sparkfun/Spectacle_Director_Board/Firmware/test.txt

SPEC
128
1
B
N
n
1.0
1.0
1.0
n
1.1
1.0
1.1
n
1.2
1.0
1.2
n
1.3
1.0
1.3
n
1.4
1.0
1.4
n
1.5
1.0
1.5
n
1.6
1.3
1.6
n
1.7
1.3
1.7
N
n
1.0
2.500
1.0
1.0
4.0
4.750
n
1.1
2.500
1.1
1.0
4.0
4.750
n
1.2
2.500
1.2
1.0
4.0
4.750
n
1.3
2.500
1.3
1.0
4.0
4.750
n
1.4
2.500
1.4
1.0
4.0
4.750
n
1.8
2.500
1.0
1.0
4.0
4.750
V
8
5
2000
Y
X
