sparkfun/Spectacle_Director_Board/(threads)

Thread 4 (2017-08-08):

No delay and no waiting loop needed after Wire.requestFrom().

Koepel, 2017-08-08:
In the file "spectacle_comms.ino" the Wire.requestFrom() is used five times. The code is not correct for all five.

The Wire.requestFrom() reads data and waits until the I2C transaction has finished. After that the received data is in a buffer in the Wire library. The Wire.read() retrieves data from that buffer and Wire.available() tells how many bytes are in that buffer.

There is nothing to wait for. The while-loops after the Wire.requestFrom() can be removed.

The isRead() function reads a byte when something is Wire.available(). That Wire.read() not needed. The next I2C transaction will start with a cleared buffer. The delay(5) after the Wire.requestFrom() is not needed for the check, but other code might depend on that delay by now.
