sparkfun/Spectacle_Director_Board/Hardware/Spectacle_Director_Board.brd

## EAGLE design Hardware/Spectacle_Director_Board.brd (2017-02-08)

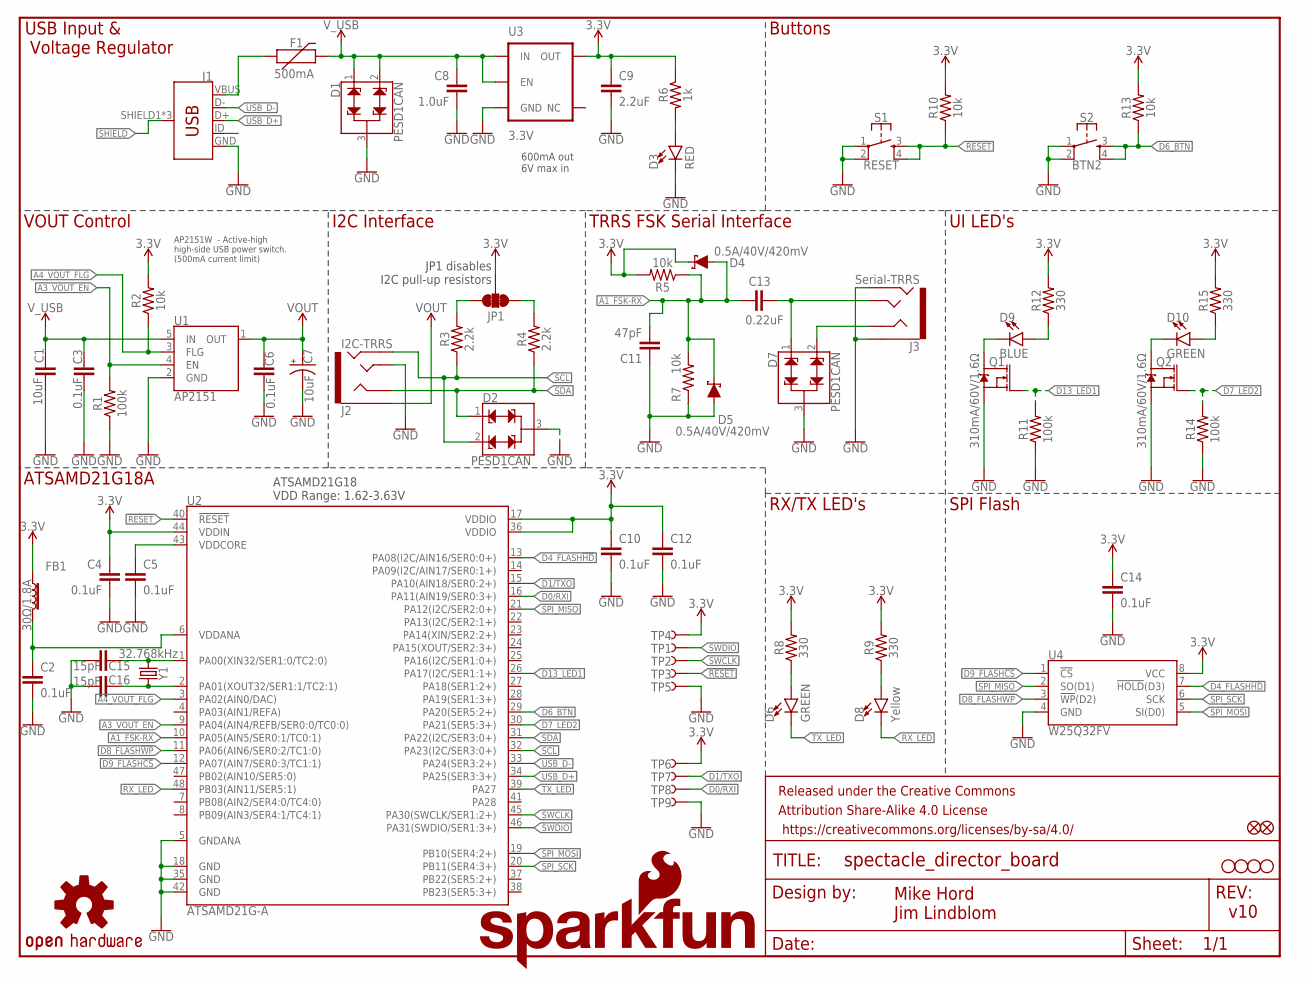
[picture p1: schematic Spectacle_Director_Board.sch]

Parts:
C1: 10uF; 0805
C2, C3, C4, C5, C6, C10, C12, C14: 0.1uF; 0603
C7: 10uF; EIA3216
C8: 1.0uF; 0805
C9: 2.2uF; 0603
C11: 47pF; 0603
C13: 0.22uF; 0603
C15, C16: 15pF; 0603
D1, D2, D7: PESD1CAN; SOT23-3
D3: RED; LED-0603
D4, D5: 0.5A/40V/420mV; SOD-323
D6, D10: GREEN; LED-0603
D8: Yellow; LED-0603
D9: BLUE; LED-0603
F1: 500mA; PTC-1206
FB1: 30Ω/1.8A; 0603
FD1, FD2: FIDUCIALUFIDUCIAL; FIDUCIAL-MICRO
FRAME1: FRAME-LETTER; CREATIVE_COMMONS
H1, H2, H3, H4: STAND-OFF
J1: USB_MICRO-B_FEMALE-SMT; USB-B-MICRO-SMD
J2: I2C-TRRS; AUDIO_JACK_3.5MM_TRRS_SMD_RA
J3: Serial-TRRS; AUDIO_JACK_3.5MM_TRRS_SMD_RA
JP1: JUMPER-SMT_3_2-NC_TRACE_NO-SILK; SMT-JUMPER_3_2-NC_TRACE_NO-SILK
LOGO1: OSHW-LOGOMINI; OSHW-LOGO-MINI
LOGO2: SFE_LOGO_NAME.2_INCH; SFE_LOGO_NAME_.2
LOGO3: SFE_LOGO_FLAME.1COP; SFE_LOGO_FLAME_COPPER_.1
Q1, Q2: 310mA/60V/1.6Ω; SOT323
R1, R11, R14: 100k; 0603
R2, R5, R7, R10, R13: 10k; 0603
R3, R4: 2.2k; 0603
R6: 1k; 0603
R8, R9, R12, R15: 330; 0603
S1: RESET; TACTILE_SWITCH_SMD_4.6X2.8MM
S2: BTN2; TACTILE_SWITCH_SMD_4.6X2.8MM
TP1: TP-SWDIO; PAD.03X.05
TP2: TP-SWCLK; PAD.03X.05
TP3: TP-!RESET!; PAD.03X.05
TP4: TP-3.3V; PAD.03X.05
TP5, TP6, TP7, TP8, TP9: TP-GND; PAD.03X.05
U1: AP2151; SOT23-5
U2: ATSAMD21G-A; TQFP-48
U3: 3.3V; SOT23-5
U4: W25Q32FV; SOIC-8
Y1: 32.768kHz; CRYSTAL-SMD-3.2X1.5MM

Connections:
3.3V: C4.1, C9.1, C10.1, C12.1, C14.1, D4.C, FB1.1, JP1.2, R2.2, R5.2, R6.1, R8.2, R9.2, R10.2, R12.2, R13.2, R15.2, TP4.P$1, TP6.P$1, U2.17 (VDDIO), U2.36 (VDDIO), U2.44 (VDDIN), U3.5 (OUT), U4.8 (VCC)
!RESET: R10.1, S1.3, S1.4, TP3.P$1, U2.40 (!RESET!)
A1_FSK-RX: C11.2, C13.1, D4.A, D5.C, R5.1, R7.2, U2.10 (PA05(AIN5/SER0:1/TC0:1))
A3_VOUT_EN: R1.2, U1.4 (EN), U2.9 (PA04(AIN4/REFB/SER0:0/TC0:0))
A4_VOUT_FLG: R2.1, U1.3 (FLG), U2.3 (PA02(AIN0/DAC))
D0/RXI: TP8.P$1, U2.16 (PA11(AIN19/SER0:3+))
D1/TXO: TP7.P$1, U2.15 (PA10(AIN18/SER0:2+))
D4_FLASH!HD!: U2.13 (PA08(I2C/AIN16/SER0:0+)), U4.7 (!HOLD!(D3))
D6_BTN: R13.1, S2.3, S2.4, U2.29 (PA20(SER5:2+))
D7_LED2: Q2.1 (G), R14.2, U2.30 (PA21(SER5:3+))
D8_FLASH!WP!: U2.11 (PA06(AIN6/SER0:2/TC1:0)), U4.3 (!WP!(D2))
D9_FLASH!CS!: U2.12 (PA07(AIN7/SER0:3/TC1:1)), U4.1 (!CS!)
D13_LED1: Q1.1 (G), R11.2, U2.26 (PA17(I2C/SER1:1+))
GND: C1.2, C2.2, C3.2, C4.2, C5.2, C6.2, C7.-, C8.2, C9.2, C10.2, C11.1, C12.2, C14.2, C15.1, C16.1, D1.3, D2.3, D3.C, D5.A, D7.3, J1.GND, J2.TIP, J3.EARTH, J3.RING2, Q1.2 (S), Q2.2 (S), R1.1, R7.1, R11.1, R14.1, S1.1, S1.2, S2.1, S2.2, TP5.P$1, TP9.P$1, U1.2 (GND), U2.5 (GNDANA), U2.18 (GND), U2.35 (GND), U2.42 (GND), U3.2 (GND), U4.4 (GND)
unnamed: D10.A, R15.1
unnamed: D3.A, R6.2
unnamed: C15.2, U2.1 (PA00(XIN32/SER1:0/TC2:0)), Y1.P$2 (2)
unnamed: JP1.3, R3.2
unnamed: JP1.1, R4.2
unnamed: C16.2, U2.2 (PA01(XOUT32/SER1:1/TC2:1)), Y1.P$1 (1)
unnamed: D10.C, Q2.3 (D)
unnamed: D9.A, R12.1
unnamed: D9.C, Q1.3 (D)
unnamed: D6.A, R8.1
unnamed: D8.A, R9.1
RING1-RIGHT: D7.2, J3.RING1
RX_LED: D8.C, U2.48 (PB03(AIN11/SER5:1))
SCL: D2.2, J2.RING2, R3.1, U2.32 (PA23(I2C/SER3:0+))
SDA: D2.1, J2.RING1, R4.1, U2.31 (PA22(I2C/SER3:0+))
SHIELD: J1.SHIELD1 (SHIELD), J1.SHIELD2 (SHIELD), J1.SHIELD3 (SHIELD)
SPI_MISO: U2.21 (PA12(I2C/SER2:0+)), U4.2 (SO(D1))
SPI_MOSI: U2.19 (PB10(SER4:2+)), U4.5 (SI(D0))
SPI_SCK: U2.20 (PB11(SER4:3+)), U4.6 (SCK)
SWCLK: TP2.P$1, U2.45 (PA30(SWCLK/SER1:2+))
SWDIO: TP1.P$1, U2.46 (PA31(SWDIO/SER1:3+))
TIP-LEFT: C13.2, D7.1, J3.TIP
TX_LED: D6.C, U2.39 (PA27)
USB_D+: J1.D+, U2.34 (PA25(SER3:3+))
USB_D-: J1.D-, U2.33 (PA24(SER3:2+))
USB_ID: J1.ID
VDDANA: C2.1, FB1.2, U2.6 (VDDANA)
VDDCORE: C5.1, U2.43 (VDDCORE)
VOUT: C6.1, C7.+, J2.EARTH, U1.1 (OUT)
VUSB: F1.1, J1.VBUS
V_USB: C1.1, C3.1, C8.1, D1.1, D1.2, F1.2, U1.5 (IN), U3.1 (IN), U3.3 (EN)

Notes on the sheet:
600mA out 6V max in
v10
Mike Hord Jim Lindblom
JP1 disables I2C pull-up resistors
ATSAMD21G18 VDD Range: 1.62-3.63V
USB Input & Voltage Regulator
Buttons
SPI Flash
ATSAMD21G18A
RX/TX LED's
UI LED's
I2C Interface
TRRS FSK Serial Interface
VOUT Control
AP2151W - Active-high high-side USB power switch. (500mA current limit)

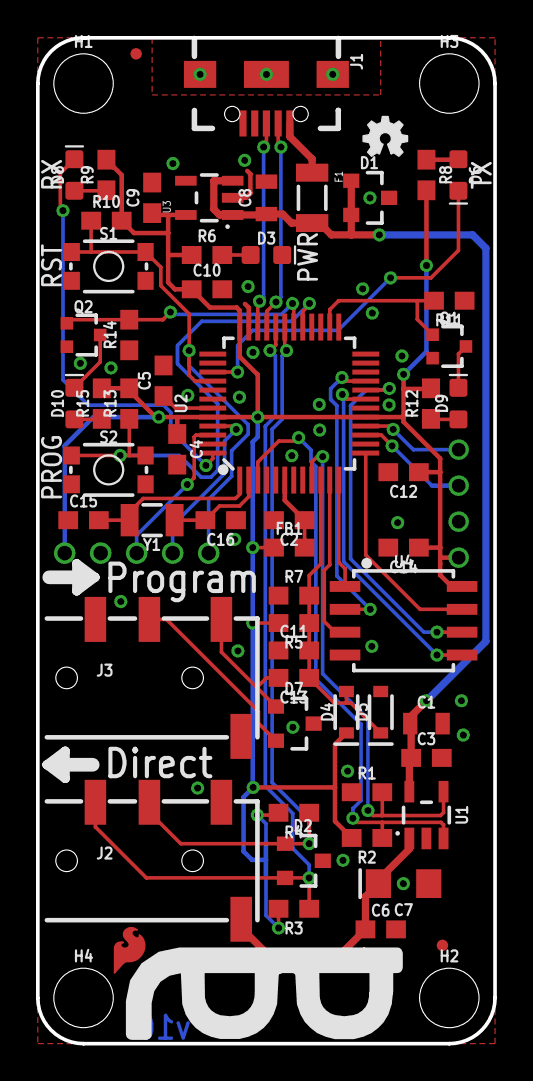
[picture p2: board Spectacle_Director_Board.brd from above]

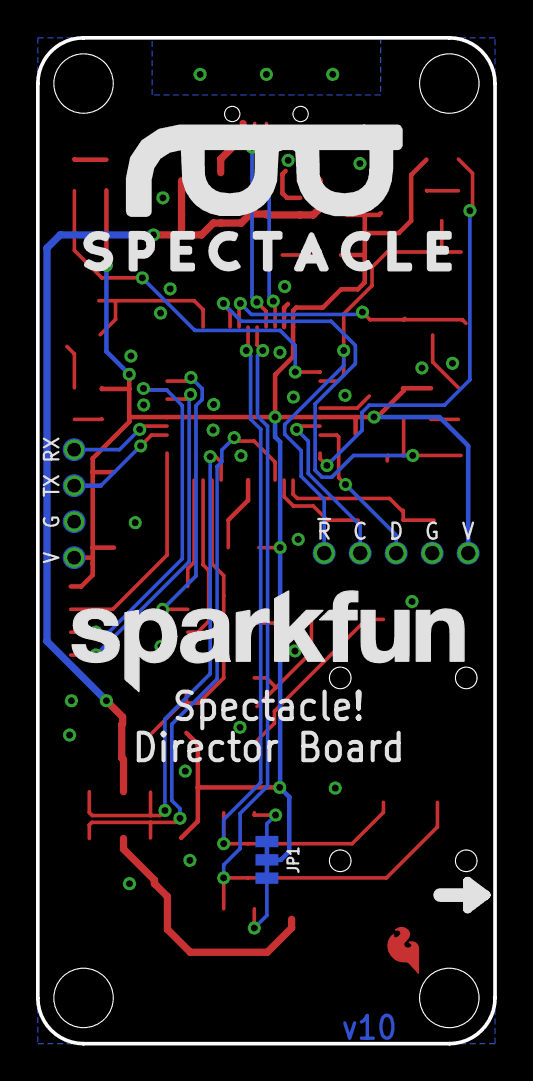
[picture p3: board Spectacle_Director_Board.brd from below]

Board: 2 copper layers, 25.4 x 55.9 mm, 76 parts (11 on the bottom side), 44 nets.

Other parts of the board:
U$1: ORDERING_INSTRUCTIONS
