sparkfun/Spectacle_Director_Board/Hardware/esp32-thing.brd

## EAGLE design Hardware/esp32-thing.brd (2016-06-13)

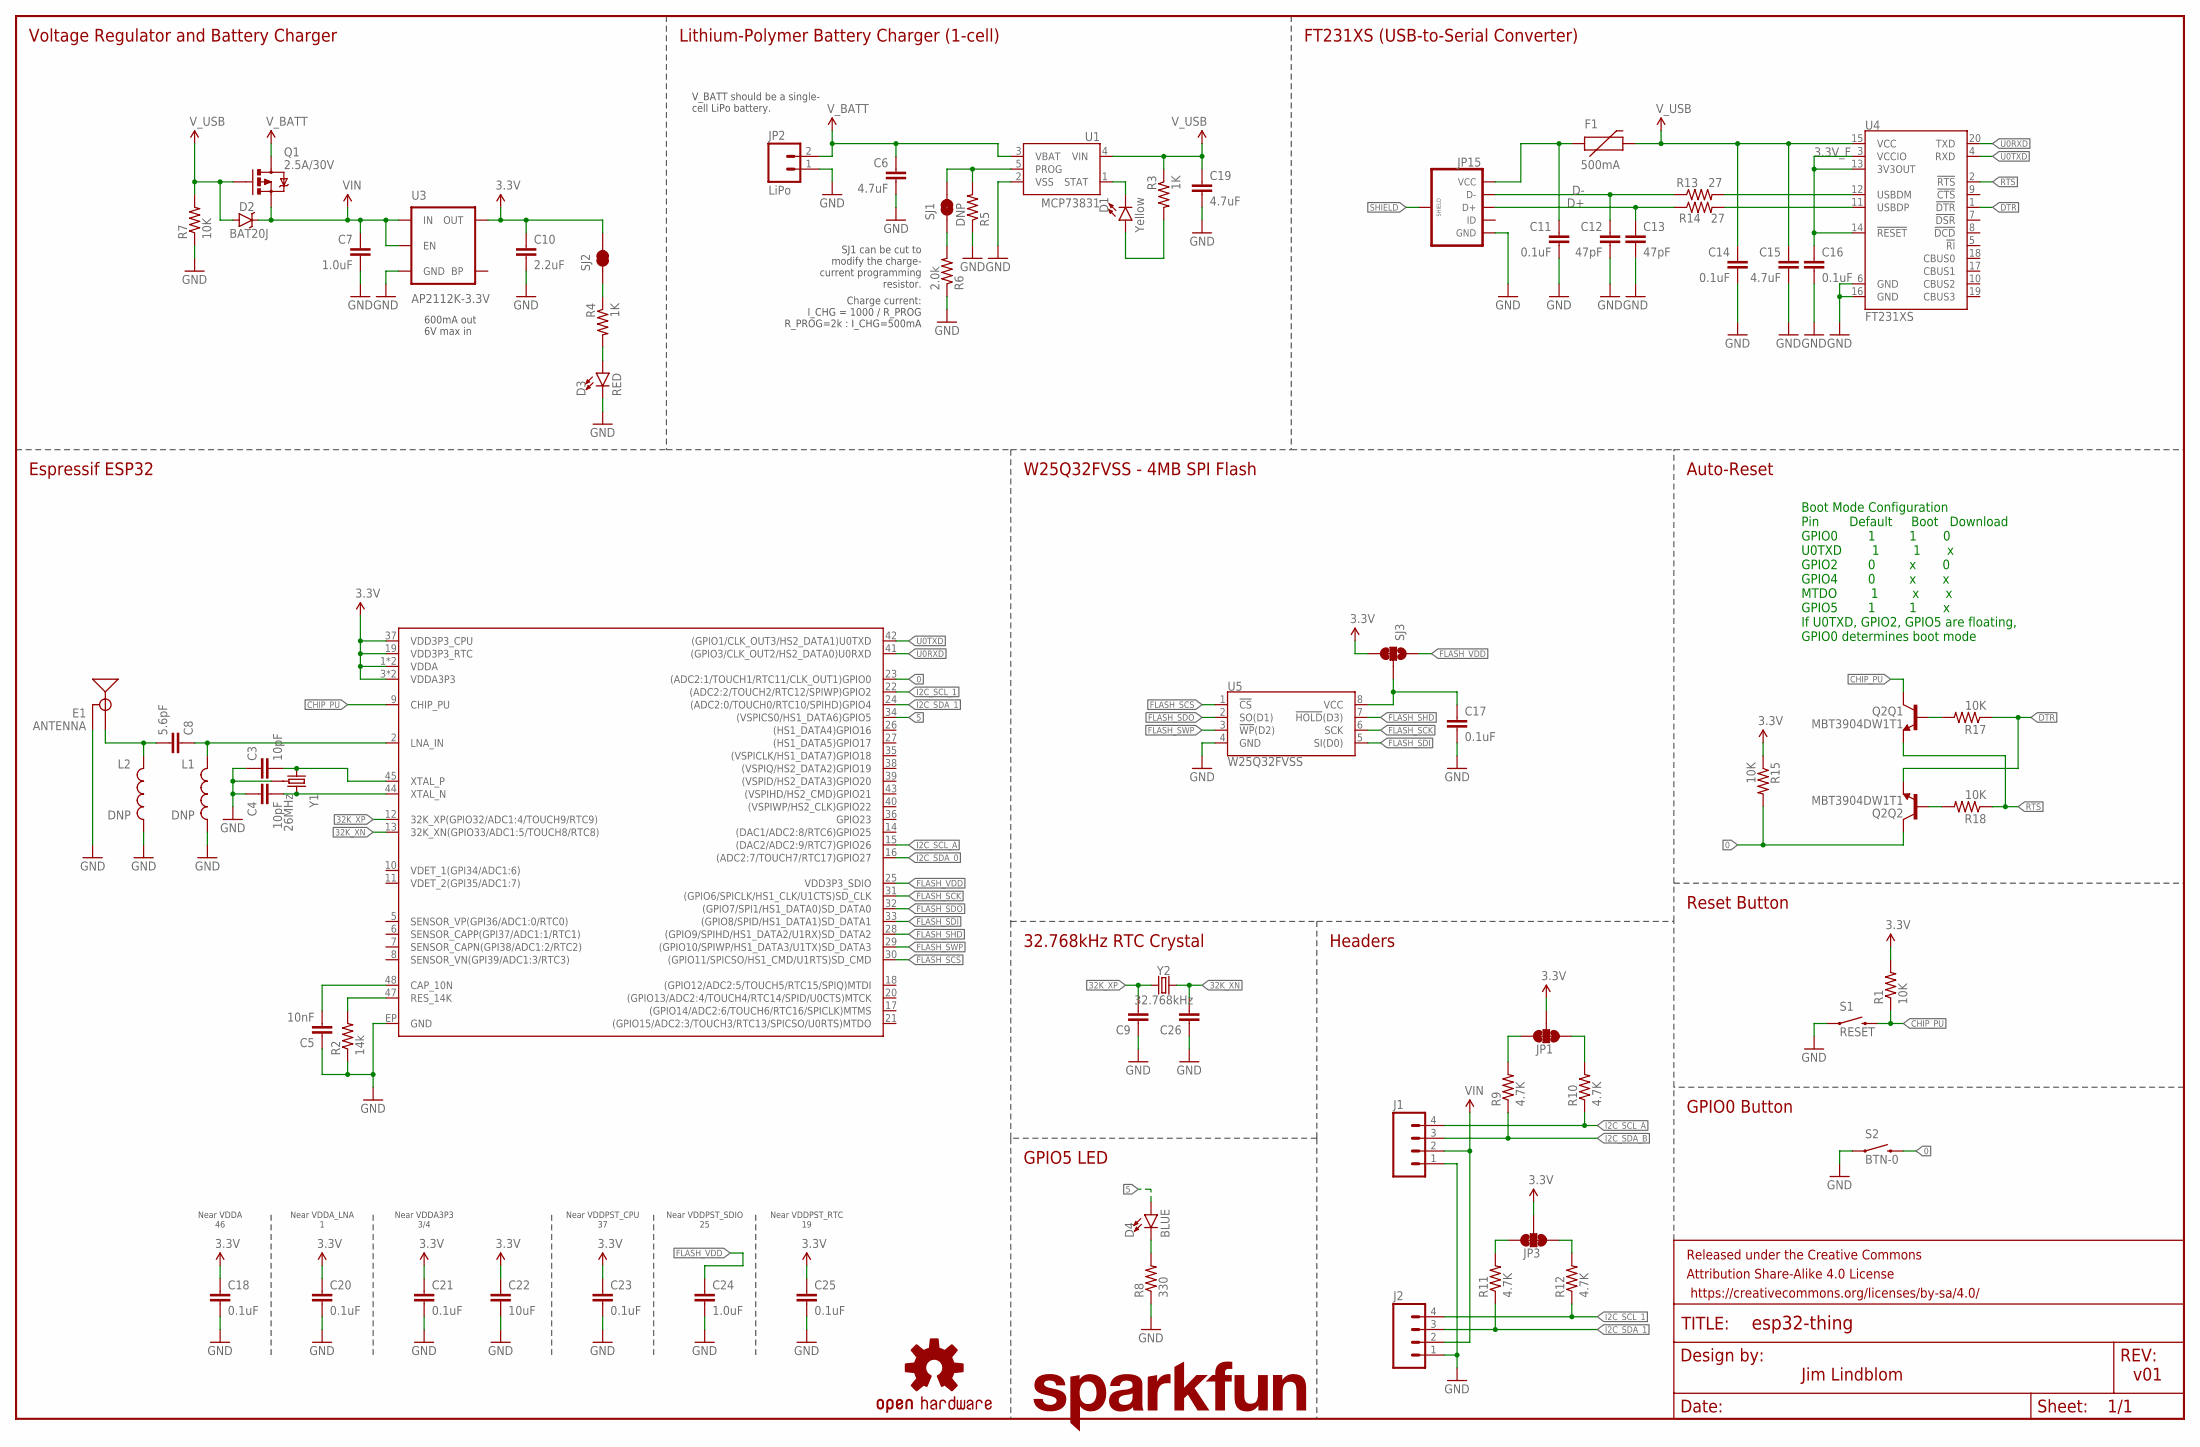
[picture p4: schematic esp32-thing.sch]

Parts:
C3, C4: 10pF; 0603-CAP
C5: 10nF; 0603-CAP
C6, C15, C19: 4.7uF; 0603-CAP
C7: 1.0uF; 0805-CAP
C8: 5.6pF; 0603-CAP
C9, C26: CAP0603-CAP; 0603-CAP
C10: 2.2uF; 0603-CAP
C11, C14, C16, C17, C18, C20, C21, C23, C25: 0.1uF; 0603-CAP
C12, C13: 47pF; 0603-CAP
C22: 10uF; 0603-CAP
C24: 1.0uF; 0603-CAP
D1: Yellow; LED-0603
D2: BAT20J; SOD-323
D3: RED; LED-0603
D4: BLUE; LED-0603
E1: ANTENNA; TRACE_ANTENNA_2.4GHZ_25.7MM_TUNED
F1: 500mA; PTC-1206
FRAME1: FRAME-LEDGER; CREATIVE_COMMONS
J1, J2: M04POLAR_LOCK; MOLEX-1X4_LOCK
JP1, JP3: JUMPER-PAD-3-NC_BY_TRACE; PAD-JUMPER-3-3OF3_NC_BY_TRACE_YES_SILK_FULL_BOX
JP2: LiPo; JST-2-PTH
JP15: USB_MICROB_PLUGCONN-11752; USB-B-MICRO-SMD_V03
L1, L2: DNP; 0603
LOGO1: SFE_LOGO_NAME.2_INCH; SFE_LOGO_NAME_.2
LOGO2: OSHW-LOGOMINI; OSHW-LOGO-MINI
Q1: 2.5A/30V; SOT23-3
Q2: MBT3904DW1T1; SC70-6
R1: 10K; 0603-RES
R2: 14k; 0603-RES
R3, R4: 1K; 0603-RES
R5: DNP; 1/6W-RES
R6: 2.0k; 0603-RES
R7, R15, R17, R18: 10K; 0603-RES@1
R8: 330; 0603-RES
R9, R10, R11, R12: 4.7K; 0603-RES
R13, R14: 27; 0603-RES
S1: RESET; TACTILE_SWITCH_SMD_4.6X2.8MM
S2: BTN-0; TACTILE_SWITCH_SMD_4.6X2.8MM
SJ1, SJ2: JUMPER-PAD-2-NC_BY_TRACE; PAD-JUMPER-2-NC_BY_TRACE_YES_SILK
SJ3: JUMPER-PAD-3-2OF3_NC_BY_TRACE_SMALL; PAD-JUMPER-3-2OF3_NC_BY_TRACE_YES_SILK_FULL_BOX
U1: MCP73831; SOT23-5
U3: AP2112K-3.3V; SOT23-5
U4: FT231XS; SSOP20_L
U5: W25Q32FVSS; SOIC-8
U$1: ESP32; QFN48-0.4MM
Y1: 26MHz; CRYSTAL-SMD-3.2X2.5
Y2: 32.768kHz; CRYSTAL-SMD-3.2X1.5MM

Connections:
0: Q2.6 (C), R15.2, S2.3 (2), S2.4 (2), U$1.23 ((ADC2:1/TOUCH1/RTC11/CLK_OUT1)GPIO0)
3.3V: C10.1, C18.1, C20.1, C21.1, C22.1, C23.1, C25.1, JP1.2, JP3.2, R1.2, R15.1, SJ2.2, SJ3.3, U3.5 (OUT), U$1.1 (VDDA), U$1.3 (VDDA3P3), U$1.4 (VDDA3P3), U$1.19 (VDD3P3_RTC), U$1.37 (VDD3P3_CPU), U$1.46 (VDDA)
3.3V_F: C16.1, U4.3 (VCCIO), U4.13 (3V3OUT), U4.14 (!RESET)
5: D4.A, U$1.34 ((VSPICS0/HS1_DATA6)GPIO5)
32K_XN: C26.2, U$1.13 (32K_XN(GPIO33/ADC1:5/TOUCH8/RTC8)), Y2.P$2 (2)
32K_XP: C9.2, U$1.12 (32K_XP(GPIO32/ADC1:4/TOUCH9/RTC9)), Y2.P$1 (1)
CAP_10N: C5.2, U$1.48 (CAP_10N)
CHIP_PU: Q2.3 (C), R1.1, S1.3 (2), S1.4 (2), U$1.9 (CHIP_PU)
D+: C13.1, JP15.D+, R14.1
D-: C12.1, JP15.D-, R13.1
DTR: Q2.1 (E), R17.1, U4.1 (!DTR)
FLASH_SCK: U5.6 (SCK), U$1.31 ((GPIO6/SPICLK/HS1_CLK/U1CTS)SD_CLK)
FLASH_SCS: U5.1 (!CS!), U$1.30 ((GPIO11/SPICSO/HS1_CMD/U1RTS)SD_CMD)
FLASH_SDI: U5.5 (SI(D0)), U$1.33 ((GPIO8/SPID/HS1_DATA1)SD_DATA1)
FLASH_SDO: U5.2 (SO(D1)), U$1.32 ((GPIO7/SPI1/HS1_DATA0)SD_DATA0)
FLASH_SHD: U5.7 (!HOLD!(D3)), U$1.28 ((GPIO9/SPIHD/HS1_DATA2/U1RX)SD_DATA2)
FLASH_SWP: U5.3 (!WP!(D2)), U$1.29 ((GPIO10/SPIWP/HS1_DATA3/U1TX)SD_DATA3)
FLASH_VDD: C24.1, SJ3.1, U$1.25 (VDD3P3_SDIO)
GND: C3.1, C4.1, C5.1, C6.2, C7.2, C9.1, C10.2, C11.2, C12.2, C13.2, C14.2, C15.2, C16.2, C17.2, C18.2, C19.2, C20.2, C21.2, C22.2, C23.2, C24.2, C25.2, C26.1, D3.C, E1.GND, E1.GND2 (GND), J1.1, J2.1, JP2.1, JP15.GND, L1.2, L2.2, R2.1, R5.1, R6.1, R7.1, R8.1, S1.1, S1.2 (1), S2.1, S2.2 (1), U1.2 (VSS), U3.2 (GND), U4.6 (GND), U4.16 (GND), U5.4 (GND), U$1.EP (GND), Y1.2 (GND), Y1.4 (GND)
I2C_SCL_1: J2.4, R12.1, U$1.22 ((ADC2:2/TOUCH2/RTC12/SPIWP)GPIO2)
I2C_SCL_A: J1.4, R10.1, U$1.15 ((DAC2/ADC2:9/RTC7)GPIO26)
I2C_SDA_0: U$1.16 ((ADC2:7/TOUCH7/RTC17)GPIO27)
I2C_SDA_1: J2.3, R11.1, U$1.24 ((ADC2:0/TOUCH0/RTC10/SPIHD)GPIO4)
I2C_SDA_B: J1.3, R9.1
LNA_IN: C8.1, L1.1, U$1.2 (LNA_IN)
unnamed: D4.C, R8.2
unnamed: D3.A, R4.2
unnamed: R4.1, SJ2.1
unnamed: JP3.3, R11.2
unnamed: JP3.1, R12.2
unnamed: JP1.3, R9.2
unnamed: R13.2, U4.12 (USBDM)
unnamed: R14.2, U4.11 (USBDP)
unnamed: D1.C, U1.1 (STAT)
unnamed: Q2.5 (B), R17.2
unnamed: JP1.1, R10.2
unnamed: Q2.2 (B), R18.2
unnamed: R5.2, SJ1.2, U1.5 (PROG)
unnamed: R6.2, SJ1.1
unnamed: D1.A, R3.2
RES_14K: R2.2, U$1.47 (RES_14K)
RTS: Q2.4 (E), R18.1, U4.2 (!RTS)
SHIELD: JP15.SHIELD1 (SHIELD), JP15.SHIELD2 (SHIELD), JP15.SHIELD3 (SHIELD)
TRACE_ANT: C8.2, E1.ANT (SIGNAL), L2.1
U0RXD: U4.20 (TXD), U$1.41 ((GPIO3/CLK_OUT2/HS2_DATA0)U0RXD)
U0TXD: U4.4 (RXD), U$1.42 ((GPIO1/CLK_OUT3/HS2_DATA1)U0TXD)
VCC_FLASH: C17.1, SJ3.2, U5.8 (VCC)
VIN: C7.1, D2.C, J1.2, J2.2, Q1.2 (S), U3.1 (IN), U3.3 (EN)
VUSB: C11.1, F1.1, JP15.VBUS (VCC)
V_BATT: C6.1, JP2.2, Q1.3 (D), U1.3 (VBAT)
V_USB: C14.1, C15.1, C19.1, D2.A, F1.2, Q1.1 (G), R3.1, R7.2, U1.4 (VIN), U4.15 (VCC)
XTAL_N_: C4.2, U$1.44 (XTAL_N), Y1.3 (2)
XTAL_P_: C3.2, U$1.45 (XTAL_P), Y1.1

Notes on the sheet:
Boot Mode Configuration Pin Default Boot Download GPIO0 1 1 0 U0TXD 1 1 x GPIO2 0 x 0 GPIO4 0 x x MTDO 1 x x GPIO5 1 1 x If U0TXD, GPIO2, GPIO5 are floating, GPIO0 determines boot mode
FT231XS (USB-to-Serial Converter)
V_BATT should be a single- cell LiPo battery.
Charge current: I_CHG = 1000 / R_PROG R_PROG=2k : I_CHG=500mA
Voltage Regulator and Battery Charger
SJ1 can be cut to modify the charge- current programming resistor.
Lithium-Polymer Battery Charger (1-cell)
600mA out 6V max in
Auto-Reset
Near VDDA 46
Near VDDA_LNA 1
Near VDDA3P3 3/4
Near VDDPST_CPU 37
Near VDDPST_SDIO 25
Near VDDPST_RTC 19
Espressif ESP32
W25Q32FVSS - 4MB SPI Flash
32.768kHz RTC Crystal
GPIO0 Button
Reset Button
GPIO5 LED
Headers
v01
Jim Lindblom

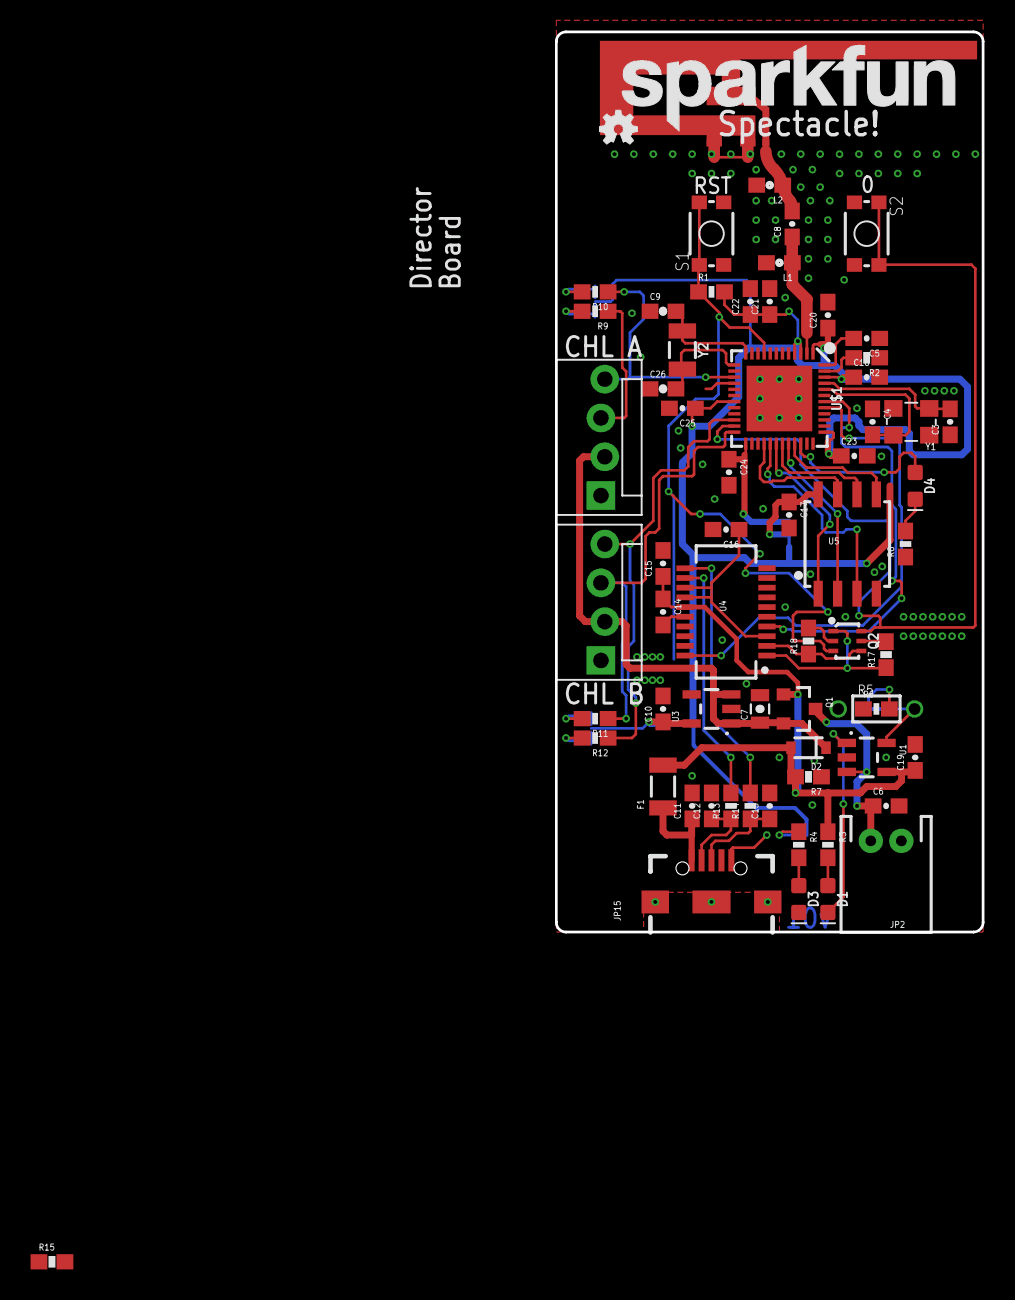
[picture p5: board esp32-thing.brd from above]

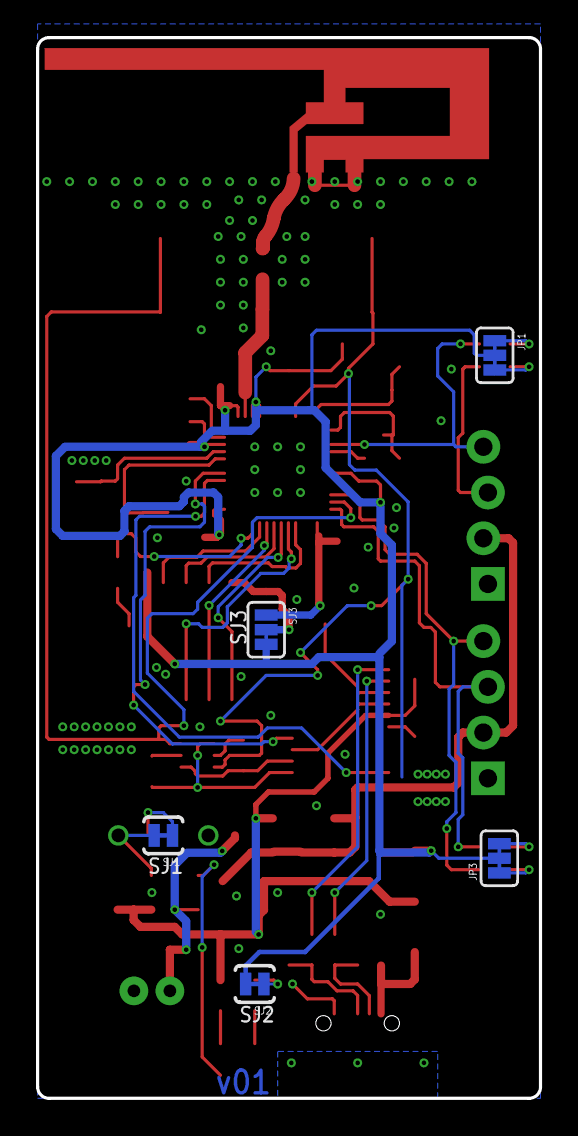
[picture p6: board esp32-thing.brd from below]

Board: 2 copper layers, 27.9 x 58.9 mm, 72 parts (5 on the bottom side), 52 nets.
