sparkfun/Spectacle_Director_Board/Production/13350-Spectacle_Director_Board-panel.v10.brd

## EAGLE design Production/13350-Spectacle_Director_Board-panel.v10.brd (2017-04-03)

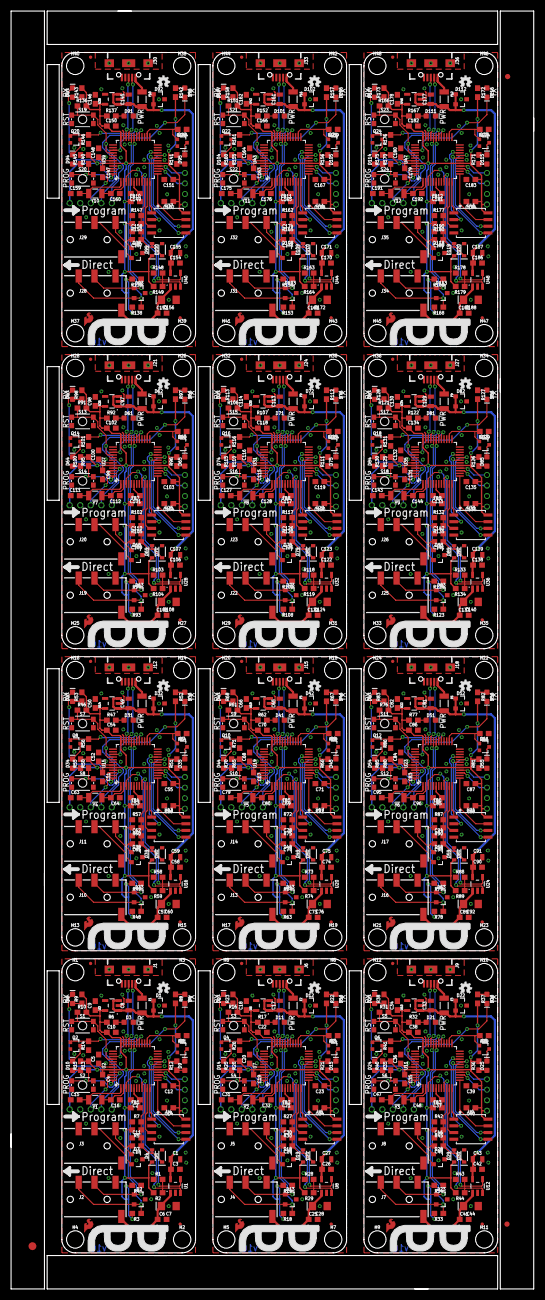
[picture p7: board 13350-Spectacle_Director_Board-panel.v10.brd from above]

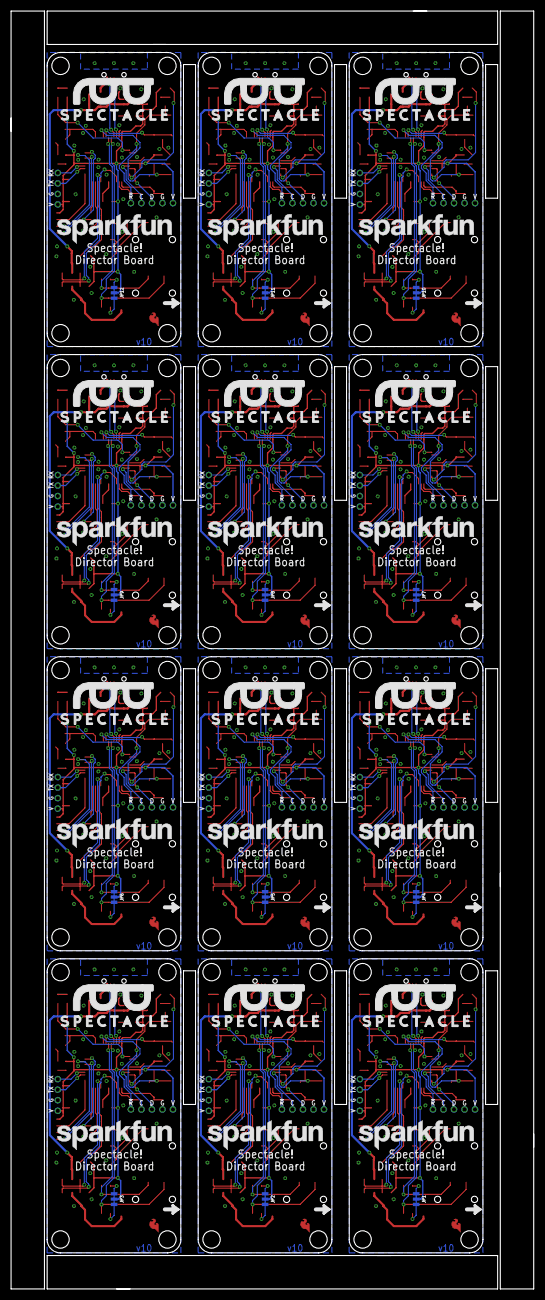
[picture p8: board 13350-Spectacle_Director_Board-panel.v10.brd from below]

Board: 2 copper layers, 99.3 x 242.8 mm, 891 parts (132 on the bottom side), 528 nets.

Parts:
C1, C27, C43, C59, C75, C91, C107, C123, C139, C155, C171, C187: 10uF; 0805
C2, C3, C4, C5, C6, C10, C12, C14, C19, C20, C21, C22, C23, C24, C25, C26, C35, C36, C37, C38, C39, C40, C41, C42, C51, C52, C53, C54, C55, C56, C57, C58, C67, C68, C69, C70, C71, C72, C73, C74, C83, C84, C85, C86, C87, C88, C89, C90, C99, C100, C101, C102, C103, C104, C105, C106, C115, C116, C117, C118, C119, C120, C121, C122, C131, C132, C133, C134, C135, C136, C137, C138, C147, C148, C149, C150, C151, C152, C153, C154, C163, C164, C165, C166, C167, C168, C169, C170, C179, C180, C181, C182, C183, C184, C185, C186: 0.1uF; 0603
C7, C28, C44, C60, C76, C92, C108, C124, C140, C156, C172, C188: 10uF; EIA3216
C8, C17, C33, C49, C65, C81, C97, C113, C129, C145, C161, C177: 1.0uF; 0805
C9, C18, C34, C50, C66, C82, C98, C114, C130, C146, C162, C178: 2.2uF; 0603
C11, C30, C46, C62, C78, C94, C110, C126, C142, C158, C174, C190: 47pF; 0603
C13, C29, C45, C61, C77, C93, C109, C125, C141, C157, C173, C189: 0.22uF; 0603
C15, C16, C31, C32, C47, C48, C63, C64, C79, C80, C95, C96, C111, C112, C127, C128, C143, C144, C159, C160, C175, C176, C191, C192: 15pF; 0603
D1, D2, D7, D12, D13, D18, D22, D23, D28, D32, D33, D38, D42, D43, D48, D52, D53, D58, D62, D63, D68, D72, D73, D78, D82, D83, D88, D92, D93, D98, D102, D103, D108, D112, D113, D118: PESD1CAN; SOT23-3
D3, D11, D21, D31, D41, D51, D61, D71, D81, D91, D101, D111: RED; LED-0603
D4, D5, D19, D20, D29, D30, D39, D40, D49, D50, D59, D60, D69, D70, D79, D80, D89, D90, D99, D100, D109, D110, D119, D120: 0.5A/40V/420mV; SOD-323
D6, D10, D14, D16, D24, D26, D34, D36, D44, D46, D54, D56, D64, D66, D74, D76, D84, D86, D94, D96, D104, D106, D114, D116: GREEN; LED-0603
D8, D17, D27, D37, D47, D57, D67, D77, D87, D97, D107, D117: Yellow; LED-0603
D9, D15, D25, D35, D45, D55, D65, D75, D85, D95, D105, D115: BLUE; LED-0603
E$1: FIDUCIAL-1.5X3
E$4, E$7: FIDUCIAL-1X2
F1, F2, F3, F4, F5, F6, F7, F8, F9, F10, F11, F12: 500mA; PTC-1206
FB1, FB2, FB3, FB4, FB5, FB6, FB7, FB8, FB9, FB10, FB11, FB12: 30Ω/1.8A; 0603
FD1, FD2, FD3, FD4, FD5, FD6, FD7, FD8, FD9, FD10, FD11, FD12, FD13, FD14, FD15, FD16, FD17, FD18, FD19, FD20, FD21, FD22, FD23, FD24: FIDUCIALUFIDUCIAL; FIDUCIAL-MICRO
H1, H2, H3, H4, H5, H6, H7, H8, H9, H10, H11, H12, H13, H14, H15, H16, H17, H18, H19, H20, H21, H22, H23, H24, H25, H26, H27, H28, H29, H30, H31, H32, H33, H34, H35, H36, H37, H38, H39, H40, H41, H42, H43, H44, H45, H46, H47, H48: STAND-OFF
J1, J6, J9, J12, J15, J18, J21, J24, J27, J30, J33, J36: USB-B-MICRO-SMD
J2, J4, J7, J10, J13, J16, J19, J22, J25, J28, J31, J34: I2C-TRRS; AUDIO_JACK_3.5MM_TRRS_SMD_RA
J3, J5, J8, J11, J14, J17, J20, J23, J26, J29, J32, J35: Serial-TRRS; AUDIO_JACK_3.5MM_TRRS_SMD_RA
JP1, JP2, JP3, JP4, JP5, JP6, JP7, JP8, JP9, JP10, JP11, JP12: JUMPER-SMT_3_2-NC_TRACE_NO-SILK; SMT-JUMPER_3_2-NC_TRACE_NO-SILK
LOGO1, LOGO5, LOGO8, LOGO11, LOGO14, LOGO17, LOGO20, LOGO23, LOGO26, LOGO29, LOGO32, LOGO35: OSHW-LOGOMINI; OSHW-LOGO-MINI
LOGO2, LOGO4, LOGO7, LOGO10, LOGO13, LOGO16, LOGO19, LOGO22, LOGO25, LOGO28, LOGO31, LOGO34: SFE_LOGO_NAME.2_INCH; SFE_LOGO_NAME_.2
LOGO3, LOGO6, LOGO9, LOGO12, LOGO15, LOGO18, LOGO21, LOGO24, LOGO27, LOGO30, LOGO33, LOGO36: SFE_LOGO_FLAME.1COP; SFE_LOGO_FLAME_COPPER_.1
Q1, Q2, Q3, Q4, Q5, Q6, Q7, Q8, Q9, Q10, Q11, Q12, Q13, Q14, Q15, Q16, Q17, Q18, Q19, Q20, Q21, Q22, Q23, Q24: 310mA/60V/1.6Ω; SOT323
R1, R11, R14, R24, R26, R28, R39, R41, R43, R54, R56, R58, R69, R71, R73, R84, R86, R88, R99, R101, R103, R114, R116, R118, R129, R131, R133, R144, R146, R148, R159, R161, R163, R174, R176, R178: 100k; 0603
R2, R5, R7, R10, R13, R16, R20, R27, R29, R30, R31, R35, R42, R44, R45, R46, R50, R57, R59, R60, R61, R65, R72, R74, R75, R76, R80, R87, R89, R90, R91, R95, R102, R104, R105, R106, R110, R117, R119, R120, R121, R125, R132, R134, R135, R136, R140, R147, R149, R150, R151, R155, R162, R164, R165, R166, R170, R177, R179, R180: 10k; 0603
R3, R4, R18, R19, R33, R34, R48, R49, R63, R64, R78, R79, R93, R94, R108, R109, R123, R124, R138, R139, R153, R154, R168, R169: 2.2k; 0603
R6, R17, R32, R47, R62, R77, R92, R107, R122, R137, R152, R167: 1k; 0603
R8, R9, R12, R15, R21, R22, R23, R25, R36, R37, R38, R40, R51, R52, R53, R55, R66, R67, R68, R70, R81, R82, R83, R85, R96, R97, R98, R100, R111, R112, R113, R115, R126, R127, R128, R130, R141, R142, R143, R145, R156, R157, R158, R160, R171, R172, R173, R175: 330; 0603
S1, S3, S5, S7, S9, S11, S13, S15, S17, S19, S21, S23: RESET; TACTILE_SWITCH_SMD_4.6X2.8MM
S2, S4, S6, S8, S10, S12, S14, S16, S18, S20, S22, S24: BTN2; TACTILE_SWITCH_SMD_4.6X2.8MM
TP1, TP10, TP19, TP28, TP37, TP46, TP55, TP64, TP73, TP82, TP91, TP100: TP-SWDIO; PAD.03X.05
TP2, TP11, TP20, TP29, TP38, TP47, TP56, TP65, TP74, TP83, TP92, TP101: TP-SWCLK; PAD.03X.05
TP3, TP12, TP21, TP30, TP39, TP48, TP57, TP66, TP75, TP84, TP93, TP102: TP-!RESET!; PAD.03X.05
TP4, TP13, TP22, TP31, TP40, TP49, TP58, TP67, TP76, TP85, TP94, TP103: TP-3.3V; PAD.03X.05
TP5, TP6, TP7, TP8, TP9, TP14, TP15, TP16, TP17, TP18, TP23, TP24, TP25, TP26, TP27, TP32, TP33, TP34, TP35, TP36, TP41, TP42, TP43, TP44, TP45, TP50, TP51, TP52, TP53, TP54, TP59, TP60, TP61, TP62, TP63, TP68, TP69, TP70, TP71, TP72, TP77, TP78, TP79, TP80, TP81, TP86, TP87, TP88, TP89, TP90, TP95, TP96, TP97, TP98, TP99, TP104, TP105, TP106, TP107, TP108: TP-GND; PAD.03X.05
U1, U8, U12, U16, U20, U24, U28, U32, U36, U40, U44, U48: AP2151; SOT23-5
U2, U7, U11, U15, U19, U23, U27, U31, U35, U39, U43, U47: ATSAMD21G-A; TQFP-48
U3, U6, U10, U14, U18, U22, U26, U30, U34, U38, U42, U46: 3.3V; SOT23-5
U4, U5, U9, U13, U17, U21, U25, U29, U33, U37, U41, U45: W25Q32FV; SOIC-8
Y1, Y2, Y3, Y4, Y5, Y6, Y7, Y8, Y9, Y10, Y11, Y12: 32.768kHz; CRYSTAL-SMD-3.2X1.5MM

Connections:
3.3V: C4.1, C9.1, C10.1, C12.1, C14.1, D4.C, FB1.1, JP1.2, R2.2, R5.2, R6.1, R8.2, R9.2, R10.2, R12.2, R13.2, R15.2, TP4.P$1, TP6.P$1, U2.17, U2.36, U2.44, U3.5, U4.8
3.3V1: C18.1, C19.1, C22.1, C23.1, C24.1, D19.C, FB2.1, JP2.2, R16.2, R17.1, R20.2, R21.2, R22.2, R23.2, R25.2, R29.2, R30.2, TP13.P$1, TP15.P$1, U5.8, U6.5, U7.17, U7.36, U7.44
3.3V2: C34.1, C35.1, C38.1, C39.1, C40.1, D29.C, FB3.1, JP3.2, R31.2, R32.1, R35.2, R36.2, R37.2, R38.2, R40.2, R44.2, R45.2, TP22.P$1, TP24.P$1, U9.8, U10.5, U11.17, U11.36, U11.44
3.3V3: C50.1, C51.1, C54.1, C55.1, C56.1, D39.C, FB4.1, JP4.2, R46.2, R47.1, R50.2, R51.2, R52.2, R53.2, R55.2, R59.2, R60.2, TP31.P$1, TP33.P$1, U13.8, U14.5, U15.17, U15.36, U15.44
3.3V4: C66.1, C67.1, C70.1, C71.1, C72.1, D49.C, FB5.1, JP5.2, R61.2, R62.1, R65.2, R66.2, R67.2, R68.2, R70.2, R74.2, R75.2, TP40.P$1, TP42.P$1, U17.8, U18.5, U19.17, U19.36, U19.44
3.3V5: C82.1, C83.1, C86.1, C87.1, C88.1, D59.C, FB6.1, JP6.2, R76.2, R77.1, R80.2, R81.2, R82.2, R83.2, R85.2, R89.2, R90.2, TP49.P$1, TP51.P$1, U21.8, U22.5, U23.17, U23.36, U23.44
3.3V6: C98.1, C99.1, C102.1, C103.1, C104.1, D69.C, FB7.1, JP7.2, R91.2, R92.1, R95.2, R96.2, R97.2, R98.2, R100.2, R104.2, R105.2, TP58.P$1, TP60.P$1, U25.8, U26.5, U27.17, U27.36, U27.44
3.3V7: C114.1, C115.1, C118.1, C119.1, C120.1, D79.C, FB8.1, JP8.2, R106.2, R107.1, R110.2, R111.2, R112.2, R113.2, R115.2, R119.2, R120.2, TP67.P$1, TP69.P$1, U29.8, U30.5, U31.17, U31.36, U31.44
3.3V8: C130.1, C131.1, C134.1, C135.1, C136.1, D89.C, FB9.1, JP9.2, R121.2, R122.1, R125.2, R126.2, R127.2, R128.2, R130.2, R134.2, R135.2, TP76.P$1, TP78.P$1, U33.8, U34.5, U35.17, U35.36, U35.44
3.3V9: C146.1, C147.1, C150.1, C151.1, C152.1, D99.C, FB10.1, JP10.2, R136.2, R137.1, R140.2, R141.2, R142.2, R143.2, R145.2, R149.2, R150.2, TP85.P$1, TP87.P$1, U37.8, U38.5, U39.17, U39.36, U39.44
3.3V10: C162.1, C163.1, C166.1, C167.1, C168.1, D109.C, FB11.1, JP11.2, R151.2, R152.1, R155.2, R156.2, R157.2, R158.2, R160.2, R164.2, R165.2, TP94.P$1, TP96.P$1, U41.8, U42.5, U43.17, U43.36, U43.44
3.3V11: C178.1, C179.1, C182.1, C183.1, C184.1, D119.C, FB12.1, JP12.2, R166.2, R167.1, R170.2, R171.2, R172.2, R173.2, R175.2, R179.2, R180.2, TP103.P$1, TP105.P$1, U45.8, U46.5, U47.17, U47.36, U47.44
!RESET: R10.1, S1.3, S1.4, TP3.P$1, U2.40
!RESET1: R16.1, S3.3, S3.4, TP12.P$1, U7.40
!RESET2: R31.1, S5.3, S5.4, TP21.P$1, U11.40
!RESET3: R46.1, S7.3, S7.4, TP30.P$1, U15.40
!RESET4: R61.1, S9.3, S9.4, TP39.P$1, U19.40
!RESET5: R76.1, S11.3, S11.4, TP48.P$1, U23.40
!RESET6: R91.1, S13.3, S13.4, TP57.P$1, U27.40
!RESET7: R106.1, S15.3, S15.4, TP66.P$1, U31.40
!RESET8: R121.1, S17.3, S17.4, TP75.P$1, U35.40
!RESET9: R136.1, S19.3, S19.4, TP84.P$1, U39.40
!RESET10: R151.1, S21.3, S21.4, TP93.P$1, U43.40
!RESET11: R166.1, S23.3, S23.4, TP102.P$1, U47.40
A1_FSK-RX: C11.2, C13.1, D4.A, D5.C, R5.1, R7.2, U2.10
A1_FSK-RX1: C29.1, C30.2, D19.A, D20.C, R27.2, R30.1, U7.10
A1_FSK-RX2: C45.1, C46.2, D29.A, D30.C, R42.2, R45.1, U11.10
A1_FSK-RX3: C61.1, C62.2, D39.A, D40.C, R57.2, R60.1, U15.10
A1_FSK-RX4: C77.1, C78.2, D49.A, D50.C, R72.2, R75.1, U19.10
A1_FSK-RX5: C93.1, C94.2, D59.A, D60.C, R87.2, R90.1, U23.10
A1_FSK-RX6: C109.1, C110.2, D69.A, D70.C, R102.2, R105.1, U27.10
A1_FSK-RX7: C125.1, C126.2, D79.A, D80.C, R117.2, R120.1, U31.10
A1_FSK-RX8: C141.1, C142.2, D89.A, D90.C, R132.2, R135.1, U35.10
A1_FSK-RX9: C157.1, C158.2, D99.A, D100.C, R147.2, R150.1, U39.10
A1_FSK-RX10: C173.1, C174.2, D109.A, D110.C, R162.2, R165.1, U43.10
A1_FSK-RX11: C189.1, C190.2, D119.A, D120.C, R177.2, R180.1, U47.10
A3_VOUT_EN: R1.2, U1.4, U2.9
A3_VOUT_EN1: R28.2, U7.9, U8.4
A3_VOUT_EN2: R43.2, U11.9, U12.4
A3_VOUT_EN3: R58.2, U15.9, U16.4
A3_VOUT_EN4: R73.2, U19.9, U20.4
A3_VOUT_EN5: R88.2, U23.9, U24.4
A3_VOUT_EN6: R103.2, U27.9, U28.4
A3_VOUT_EN7: R118.2, U31.9, U32.4
A3_VOUT_EN8: R133.2, U35.9, U36.4
A3_VOUT_EN9: R148.2, U39.9, U40.4
A3_VOUT_EN10: R163.2, U43.9, U44.4
A3_VOUT_EN11: R178.2, U47.9, U48.4
A4_VOUT_FLG: R2.1, U1.3, U2.3
A4_VOUT_FLG1: R29.1, U7.3, U8.3
A4_VOUT_FLG2: R44.1, U11.3, U12.3
A4_VOUT_FLG3: R59.1, U15.3, U16.3
A4_VOUT_FLG4: R74.1, U19.3, U20.3
A4_VOUT_FLG5: R89.1, U23.3, U24.3
A4_VOUT_FLG6: R104.1, U27.3, U28.3
A4_VOUT_FLG7: R119.1, U31.3, U32.3
A4_VOUT_FLG8: R134.1, U35.3, U36.3
A4_VOUT_FLG9: R149.1, U39.3, U40.3
A4_VOUT_FLG10: R164.1, U43.3, U44.3
A4_VOUT_FLG11: R179.1, U47.3, U48.3
D0/RXI: TP8.P$1, U2.16
D0/RXI1: TP17.P$1, U7.16
D0/RXI2: TP26.P$1, U11.16
D0/RXI3: TP35.P$1, U15.16
D0/RXI4: TP44.P$1, U19.16
D0/RXI5: TP53.P$1, U23.16
D0/RXI6: TP62.P$1, U27.16
D0/RXI7: TP71.P$1, U31.16
D0/RXI8: TP80.P$1, U35.16
D0/RXI9: TP89.P$1, U39.16
D0/RXI10: TP98.P$1, U43.16
D0/RXI11: TP107.P$1, U47.16
D1/TXO: TP7.P$1, U2.15
D1/TXO1: TP16.P$1, U7.15
D1/TXO2: TP25.P$1, U11.15
D1/TXO3: TP34.P$1, U15.15
D1/TXO4: TP43.P$1, U19.15
D1/TXO5: TP52.P$1, U23.15
D1/TXO6: TP61.P$1, U27.15
D1/TXO7: TP70.P$1, U31.15
D1/TXO8: TP79.P$1, U35.15
D1/TXO9: TP88.P$1, U39.15
D1/TXO10: TP97.P$1, U43.15
D1/TXO11: TP106.P$1, U47.15
D4_FLASH!HD!: U2.13, U4.7
D4_FLASH!HD!1: U5.7, U7.13
D4_FLASH!HD!2: U9.7, U11.13
D4_FLASH!HD!3: U13.7, U15.13
D4_FLASH!HD!4: U17.7, U19.13
D4_FLASH!HD!5: U21.7, U23.13
D4_FLASH!HD!6: U25.7, U27.13
D4_FLASH!HD!7: U29.7, U31.13
D4_FLASH!HD!8: U33.7, U35.13
D4_FLASH!HD!9: U37.7, U39.13
D4_FLASH!HD!10: U41.7, U43.13
D4_FLASH!HD!11: U45.7, U47.13
D6_BTN: R13.1, S2.3, S2.4, U2.29
D6_BTN1: R20.1, S4.3, S4.4, U7.29
D6_BTN2: R35.1, S6.3, S6.4, U11.29
D6_BTN3: R50.1, S8.3, S8.4, U15.29
D6_BTN4: R65.1, S10.3, S10.4, U19.29
D6_BTN5: R80.1, S12.3, S12.4, U23.29
D6_BTN6: R95.1, S14.3, S14.4, U27.29
D6_BTN7: R110.1, S16.3, S16.4, U31.29
D6_BTN8: R125.1, S18.3, S18.4, U35.29
D6_BTN9: R140.1, S20.3, S20.4, U39.29
D6_BTN10: R155.1, S22.3, S22.4, U43.29
D6_BTN11: R170.1, S24.3, S24.4, U47.29
D7_LED1: Q4.1, R26.2, U7.30
D7_LED2: Q2.1, R14.2, U2.30
D7_LED3: Q6.1, R41.2, U11.30
D7_LED4: Q8.1, R56.2, U15.30
D7_LED5: Q10.1, R71.2, U19.30
D7_LED6: Q12.1, R86.2, U23.30
D7_LED7: Q14.1, R101.2, U27.30
D7_LED8: Q16.1, R116.2, U31.30
D7_LED9: Q18.1, R131.2, U35.30
D7_LED10: Q20.1, R146.2, U39.30
D7_LED11: Q22.1, R161.2, U43.30
D7_LED12: Q24.1, R176.2, U47.30
D8_FLASH!WP!: U2.11, U4.3
D8_FLASH!WP!1: U5.3, U7.11
D8_FLASH!WP!2: U9.3, U11.11
D8_FLASH!WP!3: U13.3, U15.11
D8_FLASH!WP!4: U17.3, U19.11
D8_FLASH!WP!5: U21.3, U23.11
D8_FLASH!WP!6: U25.3, U27.11
D8_FLASH!WP!7: U29.3, U31.11
D8_FLASH!WP!8: U33.3, U35.11
D8_FLASH!WP!9: U37.3, U39.11
D8_FLASH!WP!10: U41.3, U43.11
D8_FLASH!WP!11: U45.3, U47.11
D9_FLASH!CS!: U2.12, U4.1
D9_FLASH!CS!1: U5.1, U7.12
D9_FLASH!CS!2: U9.1, U11.12
D9_FLASH!CS!3: U13.1, U15.12
D9_FLASH!CS!4: U17.1, U19.12
D9_FLASH!CS!5: U21.1, U23.12
D9_FLASH!CS!6: U25.1, U27.12
D9_FLASH!CS!7: U29.1, U31.12
D9_FLASH!CS!8: U33.1, U35.12
D9_FLASH!CS!9: U37.1, U39.12
D9_FLASH!CS!10: U41.1, U43.12
D9_FLASH!CS!11: U45.1, U47.12
D13_LED1: Q1.1, R11.2, U2.26
D13_LED2: Q3.1, R24.2, U7.26
D13_LED3: Q5.1, R39.2, U11.26
D13_LED4: Q7.1, R54.2, U15.26
D13_LED5: Q9.1, R69.2, U19.26
D13_LED6: Q11.1, R84.2, U23.26
D13_LED7: Q13.1, R99.2, U27.26
D13_LED8: Q15.1, R114.2, U31.26
D13_LED9: Q17.1, R129.2, U35.26
D13_LED10: Q19.1, R144.2, U39.26
D13_LED11: Q21.1, R159.2, U43.26
D13_LED12: Q23.1, R174.2, U47.26
GND: C1.2, C2.2, C3.2, C4.2, C5.2, C6.2, C7.-, C8.2, C9.2, C10.2, C11.1, C12.2, C14.2, C15.1, C16.1, D1.3, D2.3, D3.C, D5.A, D7.3, J1.GND, J2.TIP, J3.EARTH, J3.RING2, Q1.2, Q2.2, R1.1, R7.1, R11.1, R14.1, S1.1, S1.2, S2.1, S2.2, TP5.P$1, TP9.P$1, U1.2, U2.5, U2.18, U2.35, U2.42, U3.2, U4.4
GND1: C17.2, C18.2, C19.2, C20.2, C21.2, C22.2, C23.2, C24.2, C25.2, C26.2, C27.2, C28.-, C30.1, C31.1, C32.1, D11.C, D12.3, D13.3, D18.3, D20.A, J4.TIP, J5.EARTH, J5.RING2, J6.GND, Q3.2, Q4.2, R24.1, R26.1, R27.1, R28.1, S3.1, S3.2, S4.1, S4.2, TP14.P$1, TP18.P$1, U5.4, U6.2, U7.5, U7.18, U7.35, U7.42, U8.2
GND2: C33.2, C34.2, C35.2, C36.2, C37.2, C38.2, C39.2, C40.2, C41.2, C42.2, C43.2, C44.-, C46.1, C47.1, C48.1, D21.C, D22.3, D23.3, D28.3, D30.A, J7.TIP, J8.EARTH, J8.RING2, J9.GND, Q5.2, Q6.2, R39.1, R41.1, R42.1, R43.1, S5.1, S5.2, S6.1, S6.2, TP23.P$1, TP27.P$1, U9.4, U10.2, U11.5, U11.18, U11.35, U11.42, U12.2
GND3: C49.2, C50.2, C51.2, C52.2, C53.2, C54.2, C55.2, C56.2, C57.2, C58.2, C59.2, C60.-, C62.1, C63.1, C64.1, D31.C, D32.3, D33.3, D38.3, D40.A, J10.TIP, J11.EARTH, J11.RING2, J12.GND, Q7.2, Q8.2, R54.1, R56.1, R57.1, R58.1, S7.1, S7.2, S8.1, S8.2, TP32.P$1, TP36.P$1, U13.4, U14.2, U15.5, U15.18, U15.35, U15.42, U16.2
GND4: C65.2, C66.2, C67.2, C68.2, C69.2, C70.2, C71.2, C72.2, C73.2, C74.2, C75.2, C76.-, C78.1, C79.1, C80.1, D41.C, D42.3, D43.3, D48.3, D50.A, J13.TIP, J14.EARTH, J14.RING2, J15.GND, Q9.2, Q10.2, R69.1, R71.1, R72.1, R73.1, S9.1, S9.2, S10.1, S10.2, TP41.P$1, TP45.P$1, U17.4, U18.2, U19.5, U19.18, U19.35, U19.42, U20.2
GND5: C81.2, C82.2, C83.2, C84.2, C85.2, C86.2, C87.2, C88.2, C89.2, C90.2, C91.2, C92.-, C94.1, C95.1, C96.1, D51.C, D52.3, D53.3, D58.3, D60.A, J16.TIP, J17.EARTH, J17.RING2, J18.GND, Q11.2, Q12.2, R84.1, R86.1, R87.1, R88.1, S11.1, S11.2, S12.1, S12.2, TP50.P$1, TP54.P$1, U21.4, U22.2, U23.5, U23.18, U23.35, U23.42, U24.2
GND6: C97.2, C98.2, C99.2, C100.2, C101.2, C102.2, C103.2, C104.2, C105.2, C106.2, C107.2, C108.-, C110.1, C111.1, C112.1, D61.C, D62.3, D63.3, D68.3, D70.A, J19.TIP, J20.EARTH, J20.RING2, J21.GND, Q13.2, Q14.2, R99.1, R101.1, R102.1, R103.1, S13.1, S13.2, S14.1, S14.2, TP59.P$1, TP63.P$1, U25.4, U26.2, U27.5, U27.18, U27.35, U27.42, U28.2
GND7: C113.2, C114.2, C115.2, C116.2, C117.2, C118.2, C119.2, C120.2, C121.2, C122.2, C123.2, C124.-, C126.1, C127.1, C128.1, D71.C, D72.3, D73.3, D78.3, D80.A, J22.TIP, J23.EARTH, J23.RING2, J24.GND, Q15.2, Q16.2, R114.1, R116.1, R117.1, R118.1, S15.1, S15.2, S16.1, S16.2, TP68.P$1, TP72.P$1, U29.4, U30.2, U31.5, U31.18, U31.35, U31.42, U32.2
GND8: C129.2, C130.2, C131.2, C132.2, C133.2, C134.2, C135.2, C136.2, C137.2, C138.2, C139.2, C140.-, C142.1, C143.1, C144.1, D81.C, D82.3, D83.3, D88.3, D90.A, J25.TIP, J26.EARTH, J26.RING2, J27.GND, Q17.2, Q18.2, R129.1, R131.1, R132.1, R133.1, S17.1, S17.2, S18.1, S18.2, TP77.P$1, TP81.P$1, U33.4, U34.2, U35.5, U35.18, U35.35, U35.42, U36.2
GND9: C145.2, C146.2, C147.2, C148.2, C149.2, C150.2, C151.2, C152.2, C153.2, C154.2, C155.2, C156.-, C158.1, C159.1, C160.1, D91.C, D92.3, D93.3, D98.3, D100.A, J28.TIP, J29.EARTH, J29.RING2, J30.GND, Q19.2, Q20.2, R144.1, R146.1, R147.1, R148.1, S19.1, S19.2, S20.1, S20.2, TP86.P$1, TP90.P$1, U37.4, U38.2, U39.5, U39.18, U39.35, U39.42, U40.2
GND10: C161.2, C162.2, C163.2, C164.2, C165.2, C166.2, C167.2, C168.2, C169.2, C170.2, C171.2, C172.-, C174.1, C175.1, C176.1, D101.C, D102.3, D103.3, D108.3, D110.A, J31.TIP, J32.EARTH, J32.RING2, J33.GND, Q21.2, Q22.2, R159.1, R161.1, R162.1, R163.1, S21.1, S21.2, S22.1, S22.2, TP95.P$1, TP99.P$1, U41.4, U42.2, U43.5, U43.18, U43.35, U43.42, U44.2
GND11: C177.2, C178.2, C179.2, C180.2, C181.2, C182.2, C183.2, C184.2, C185.2, C186.2, C187.2, C188.-, C190.1, C191.1, C192.1, D111.C, D112.3, D113.3, D118.3, D120.A, J34.TIP, J35.EARTH, J35.RING2, J36.GND, Q23.2, Q24.2, R174.1, R176.1, R177.1, R178.1, S23.1, S23.2, S24.1, S24.2, TP104.P$1, TP108.P$1, U45.4, U46.2, U47.5, U47.18, U47.35, U47.42, U48.2
unnamed: D10.A, R15.1
unnamed: D3.A, R6.2
unnamed: C15.2, U2.1, Y1.P$2
unnamed: JP1.3, R3.2
unnamed: JP1.1, R4.2
unnamed: C16.2, U2.2, Y1.P$1
unnamed: D10.C, Q2.3
unnamed: D11.A, R17.2
unnamed: D9.A, R12.1
unnamed: D9.C, Q1.3
unnamed: D6.A, R8.1
unnamed: D8.A, R9.1
unnamed: JP2.3, R18.2
unnamed: JP2.1, R19.2
unnamed: D15.A, R21.1
unnamed: D15.C, Q3.3
unnamed: D16.A, R22.1
unnamed: D17.A, R23.1
unnamed: D14.A, R25.1
unnamed: D14.C, Q4.3
unnamed: C31.2, U7.1, Y2.P$2
unnamed: C32.2, U7.2, Y2.P$1
unnamed: D21.A, R32.2
unnamed: JP3.3, R33.2
unnamed: JP3.1, R34.2
unnamed: D25.A, R36.1
unnamed: D25.C, Q5.3
unnamed: D26.A, R37.1
unnamed: D27.A, R38.1
unnamed: D24.A, R40.1
unnamed: D24.C, Q6.3
unnamed: C47.2, U11.1, Y3.P$2
unnamed: C48.2, U11.2, Y3.P$1
unnamed: D31.A, R47.2
unnamed: JP4.3, R48.2
unnamed: JP4.1, R49.2
unnamed: D35.A, R51.1
unnamed: D35.C, Q7.3
unnamed: D36.A, R52.1
unnamed: D37.A, R53.1
unnamed: D34.A, R55.1
unnamed: D34.C, Q8.3
unnamed: C63.2, U15.1, Y4.P$2
unnamed: C64.2, U15.2, Y4.P$1
unnamed: D41.A, R62.2
unnamed: JP5.3, R63.2
unnamed: JP5.1, R64.2
unnamed: D45.A, R66.1
unnamed: D45.C, Q9.3
unnamed: D46.A, R67.1
unnamed: D47.A, R68.1
unnamed: D44.A, R70.1
unnamed: D44.C, Q10.3
unnamed: C79.2, U19.1, Y5.P$2
unnamed: C80.2, U19.2, Y5.P$1
unnamed: D51.A, R77.2
unnamed: JP6.3, R78.2
unnamed: JP6.1, R79.2
unnamed: D55.A, R81.1
unnamed: D55.C, Q11.3
unnamed: D56.A, R82.1
unnamed: D57.A, R83.1
unnamed: D54.A, R85.1
unnamed: D54.C, Q12.3
unnamed: C95.2, U23.1, Y6.P$2
unnamed: C96.2, U23.2, Y6.P$1
unnamed: D61.A, R92.2
unnamed: JP7.3, R93.2
unnamed: JP7.1, R94.2
unnamed: D65.A, R96.1
unnamed: D65.C, Q13.3
unnamed: D66.A, R97.1
unnamed: D67.A, R98.1
unnamed: D64.A, R100.1
unnamed: D64.C, Q14.3
unnamed: C111.2, U27.1, Y7.P$2
unnamed: C112.2, U27.2, Y7.P$1
unnamed: D71.A, R107.2
unnamed: JP8.3, R108.2
unnamed: JP8.1, R109.2
unnamed: D75.A, R111.1
unnamed: D75.C, Q15.3
unnamed: D76.A, R112.1
unnamed: D77.A, R113.1
unnamed: D74.A, R115.1
unnamed: D74.C, Q16.3
unnamed: C127.2, U31.1, Y8.P$2
unnamed: C128.2, U31.2, Y8.P$1
unnamed: D81.A, R122.2
unnamed: JP9.3, R123.2
unnamed: JP9.1, R124.2
unnamed: D85.A, R126.1
unnamed: D85.C, Q17.3
unnamed: D86.A, R127.1
unnamed: D87.A, R128.1
unnamed: D84.A, R130.1
unnamed: D84.C, Q18.3
unnamed: C143.2, U35.1, Y9.P$2
unnamed: C144.2, U35.2, Y9.P$1
unnamed: D91.A, R137.2
unnamed: JP10.3, R138.2
unnamed: JP10.1, R139.2
unnamed: D95.A, R141.1
unnamed: D95.C, Q19.3
unnamed: D96.A, R142.1
unnamed: D97.A, R143.1
unnamed: D94.A, R145.1
unnamed: D94.C, Q20.3
unnamed: C159.2, U39.1, Y10.P$2
unnamed: C160.2, U39.2, Y10.P$1
unnamed: D101.A, R152.2
unnamed: JP11.3, R153.2
unnamed: JP11.1, R154.2
unnamed: D105.A, R156.1
unnamed: D105.C, Q21.3
unnamed: D106.A, R157.1
unnamed: D107.A, R158.1
unnamed: D104.A, R160.1
unnamed: D104.C, Q22.3
unnamed: C175.2, U43.1, Y11.P$2
unnamed: C176.2, U43.2, Y11.P$1
unnamed: D111.A, R167.2
unnamed: JP12.3, R168.2
unnamed: JP12.1, R169.2
unnamed: D115.A, R171.1
unnamed: D115.C, Q23.3
unnamed: D116.A, R172.1
unnamed: D117.A, R173.1
unnamed: D114.A, R175.1
unnamed: D114.C, Q24.3
unnamed: C191.2, U47.1, Y12.P$2
unnamed: C192.2, U47.2, Y12.P$1
RING1-RIGHT: D7.2, J3.RING1
RING1-RIGHT1: D18.2, J5.RING1
RING1-RIGHT2: D28.2, J8.RING1
RING1-RIGHT3: D38.2, J11.RING1
RING1-RIGHT4: D48.2, J14.RING1
RING1-RIGHT5: D58.2, J17.RING1
RING1-RIGHT6: D68.2, J20.RING1
RING1-RIGHT7: D78.2, J23.RING1
RING1-RIGHT8: D88.2, J26.RING1
RING1-RIGHT9: D98.2, J29.RING1
RING1-RIGHT10: D108.2, J32.RING1
RING1-RIGHT11: D118.2, J35.RING1
RX_LED: D8.C, U2.48
RX_LED1: D17.C, U7.48
RX_LED2: D27.C, U11.48
RX_LED3: D37.C, U15.48
RX_LED4: D47.C, U19.48
RX_LED5: D57.C, U23.48
RX_LED6: D67.C, U27.48
RX_LED7: D77.C, U31.48
RX_LED8: D87.C, U35.48
RX_LED9: D97.C, U39.48
RX_LED10: D107.C, U43.48
RX_LED11: D117.C, U47.48
SCL: D2.2, J2.RING2, R3.1, U2.32
SCL1: D13.2, J4.RING2, R18.1, U7.32
SCL2: D23.2, J7.RING2, R33.1, U11.32
SCL3: D33.2, J10.RING2, R48.1, U15.32
SCL4: D43.2, J13.RING2, R63.1, U19.32
SCL5: D53.2, J16.RING2, R78.1, U23.32
SCL6: D63.2, J19.RING2, R93.1, U27.32
SCL7: D73.2, J22.RING2, R108.1, U31.32
SCL8: D83.2, J25.RING2, R123.1, U35.32
SCL9: D93.2, J28.RING2, R138.1, U39.32
SCL10: D103.2, J31.RING2, R153.1, U43.32
SCL11: D113.2, J34.RING2, R168.1, U47.32
SDA: D2.1, J2.RING1, R4.1, U2.31
SDA1: D13.1, J4.RING1, R19.1, U7.31
SDA2: D23.1, J7.RING1, R34.1, U11.31
SDA3: D33.1, J10.RING1, R49.1, U15.31
SDA4: D43.1, J13.RING1, R64.1, U19.31
SDA5: D53.1, J16.RING1, R79.1, U23.31
SDA6: D63.1, J19.RING1, R94.1, U27.31
SDA7: D73.1, J22.RING1, R109.1, U31.31
SDA8: D83.1, J25.RING1, R124.1, U35.31
SDA9: D93.1, J28.RING1, R139.1, U39.31
SDA10: D103.1, J31.RING1, R154.1, U43.31
SDA11: D113.1, J34.RING1, R169.1, U47.31
SHIELD: J1.SHIELD1, J1.SHIELD2, J1.SHIELD3
SHIELD1: J6.SHIELD1, J6.SHIELD2, J6.SHIELD3
SHIELD2: J9.SHIELD1, J9.SHIELD2, J9.SHIELD3
SHIELD3: J12.SHIELD1, J12.SHIELD2, J12.SHIELD3
SHIELD4: J15.SHIELD1, J15.SHIELD2, J15.SHIELD3
SHIELD5: J18.SHIELD1, J18.SHIELD2, J18.SHIELD3
SHIELD6: J21.SHIELD1, J21.SHIELD2, J21.SHIELD3
SHIELD7: J24.SHIELD1, J24.SHIELD2, J24.SHIELD3
SHIELD8: J27.SHIELD1, J27.SHIELD2, J27.SHIELD3
SHIELD9: J30.SHIELD1, J30.SHIELD2, J30.SHIELD3
SHIELD10: J33.SHIELD1, J33.SHIELD2, J33.SHIELD3
SHIELD11: J36.SHIELD1, J36.SHIELD2, J36.SHIELD3
SPI_MISO: U2.21, U4.2
SPI_MISO1: U5.2, U7.21
SPI_MISO2: U9.2, U11.21
SPI_MISO3: U13.2, U15.21
SPI_MISO4: U17.2, U19.21
SPI_MISO5: U21.2, U23.21
SPI_MISO6: U25.2, U27.21
SPI_MISO7: U29.2, U31.21
SPI_MISO8: U33.2, U35.21
SPI_MISO9: U37.2, U39.21
SPI_MISO10: U41.2, U43.21
SPI_MISO11: U45.2, U47.21
SPI_MOSI: U2.19, U4.5
SPI_MOSI1: U5.5, U7.19
SPI_MOSI2: U9.5, U11.19
SPI_MOSI3: U13.5, U15.19
SPI_MOSI4: U17.5, U19.19
SPI_MOSI5: U21.5, U23.19
SPI_MOSI6: U25.5, U27.19
SPI_MOSI7: U29.5, U31.19
SPI_MOSI8: U33.5, U35.19
SPI_MOSI9: U37.5, U39.19
SPI_MOSI10: U41.5, U43.19
SPI_MOSI11: U45.5, U47.19
SPI_SCK: U2.20, U4.6
SPI_SCK1: U5.6, U7.20
SPI_SCK2: U9.6, U11.20
SPI_SCK3: U13.6, U15.20
SPI_SCK4: U17.6, U19.20
SPI_SCK5: U21.6, U23.20
SPI_SCK6: U25.6, U27.20
SPI_SCK7: U29.6, U31.20
SPI_SCK8: U33.6, U35.20
SPI_SCK9: U37.6, U39.20
SPI_SCK10: U41.6, U43.20
SPI_SCK11: U45.6, U47.20
SWCLK: TP2.P$1, U2.45
SWCLK1: TP11.P$1, U7.45
SWCLK2: TP20.P$1, U11.45
SWCLK3: TP29.P$1, U15.45
SWCLK4: TP38.P$1, U19.45
SWCLK5: TP47.P$1, U23.45
SWCLK6: TP56.P$1, U27.45
SWCLK7: TP65.P$1, U31.45
SWCLK8: TP74.P$1, U35.45
SWCLK9: TP83.P$1, U39.45
SWCLK10: TP92.P$1, U43.45
SWCLK11: TP101.P$1, U47.45
SWDIO: TP1.P$1, U2.46
SWDIO1: TP10.P$1, U7.46
SWDIO2: TP19.P$1, U11.46
SWDIO3: TP28.P$1, U15.46
SWDIO4: TP37.P$1, U19.46
SWDIO5: TP46.P$1, U23.46
SWDIO6: TP55.P$1, U27.46
SWDIO7: TP64.P$1, U31.46
SWDIO8: TP73.P$1, U35.46
SWDIO9: TP82.P$1, U39.46
SWDIO10: TP91.P$1, U43.46
SWDIO11: TP100.P$1, U47.46
TIP-LEFT: C13.2, D7.1, J3.TIP
TIP-LEFT1: C29.2, D18.1, J5.TIP
TIP-LEFT2: C45.2, D28.1, J8.TIP
TIP-LEFT3: C61.2, D38.1, J11.TIP
TIP-LEFT4: C77.2, D48.1, J14.TIP
TIP-LEFT5: C93.2, D58.1, J17.TIP
TIP-LEFT6: C109.2, D68.1, J20.TIP
TIP-LEFT7: C125.2, D78.1, J23.TIP
TIP-LEFT8: C141.2, D88.1, J26.TIP
TIP-LEFT9: C157.2, D98.1, J29.TIP
TIP-LEFT10: C173.2, D108.1, J32.TIP
TIP-LEFT11: C189.2, D118.1, J35.TIP
TX_LED: D6.C, U2.39
TX_LED1: D16.C, U7.39
TX_LED2: D26.C, U11.39
TX_LED3: D36.C, U15.39
TX_LED4: D46.C, U19.39
TX_LED5: D56.C, U23.39
TX_LED6: D66.C, U27.39
TX_LED7: D76.C, U31.39
TX_LED8: D86.C, U35.39
TX_LED9: D96.C, U39.39
TX_LED10: D106.C, U43.39
TX_LED11: D116.C, U47.39
USB_D+: J1.D+, U2.34
USB_D+1: J6.D+, U7.34
USB_D+2: J9.D+, U11.34
USB_D+3: J12.D+, U15.34
USB_D+4: J15.D+, U19.34
USB_D+5: J18.D+, U23.34
USB_D+6: J21.D+, U27.34
USB_D+7: J24.D+, U31.34
USB_D+8: J27.D+, U35.34
USB_D+9: J30.D+, U39.34
USB_D+10: J33.D+, U43.34
USB_D+11: J36.D+, U47.34
USB_D-: J1.D-, U2.33
USB_D-1: J6.D-, U7.33
USB_D-2: J9.D-, U11.33
USB_D-3: J12.D-, U15.33
USB_D-4: J15.D-, U19.33
USB_D-5: J18.D-, U23.33
USB_D-6: J21.D-, U27.33
USB_D-7: J24.D-, U31.33
USB_D-8: J27.D-, U35.33
USB_D-9: J30.D-, U39.33
USB_D-10: J33.D-, U43.33
USB_D-11: J36.D-, U47.33
VDDANA: C2.1, FB1.2, U2.6
VDDANA1: C21.1, FB2.2, U7.6
VDDANA2: C37.1, FB3.2, U11.6
VDDANA3: C53.1, FB4.2, U15.6
VDDANA4: C69.1, FB5.2, U19.6
VDDANA5: C85.1, FB6.2, U23.6
VDDANA6: C101.1, FB7.2, U27.6
VDDANA7: C117.1, FB8.2, U31.6
VDDANA8: C133.1, FB9.2, U35.6
VDDANA9: C149.1, FB10.2, U39.6
VDDANA10: C165.1, FB11.2, U43.6
VDDANA11: C181.1, FB12.2, U47.6
VDDCORE: C5.1, U2.43
VDDCORE1: C20.1, U7.43
VDDCORE2: C36.1, U11.43
VDDCORE3: C52.1, U15.43
VDDCORE4: C68.1, U19.43
VDDCORE5: C84.1, U23.43
VDDCORE6: C100.1, U27.43
VDDCORE7: C116.1, U31.43
VDDCORE8: C132.1, U35.43
VDDCORE9: C148.1, U39.43
VDDCORE10: C164.1, U43.43
VDDCORE11: C180.1, U47.43
VOUT: C6.1, C7.+, J2.EARTH, U1.1
VOUT1: C25.1, C28.+, J4.EARTH, U8.1
VOUT2: C41.1, C44.+, J7.EARTH, U12.1
VOUT3: C57.1, C60.+, J10.EARTH, U16.1
VOUT4: C73.1, C76.+, J13.EARTH, U20.1
VOUT5: C89.1, C92.+, J16.EARTH, U24.1
VOUT6: C105.1, C108.+, J19.EARTH, U28.1
VOUT7: C121.1, C124.+, J22.EARTH, U32.1
VOUT8: C137.1, C140.+, J25.EARTH, U36.1
VOUT9: C153.1, C156.+, J28.EARTH, U40.1
VOUT10: C169.1, C172.+, J31.EARTH, U44.1
VOUT11: C185.1, C188.+, J34.EARTH, U48.1
VUSB: F1.1, J1.VBUS
VUSB1: F2.1, J6.VBUS
VUSB2: F3.1, J9.VBUS
VUSB3: F4.1, J12.VBUS
VUSB4: F5.1, J15.VBUS
VUSB5: F6.1, J18.VBUS
VUSB6: F7.1, J21.VBUS
VUSB7: F8.1, J24.VBUS
VUSB8: F9.1, J27.VBUS
VUSB9: F10.1, J30.VBUS
VUSB10: F11.1, J33.VBUS
VUSB11: F12.1, J36.VBUS
V_USB: C1.1, C3.1, C8.1, D1.1, D1.2, F1.2, U1.5, U3.1, U3.3
V_USB1: C17.1, C26.1, C27.1, D12.1, D12.2, F2.2, U6.1, U6.3, U8.5
V_USB2: C33.1, C42.1, C43.1, D22.1, D22.2, F3.2, U10.1, U10.3, U12.5
V_USB3: C49.1, C58.1, C59.1, D32.1, D32.2, F4.2, U14.1, U14.3, U16.5
V_USB4: C65.1, C74.1, C75.1, D42.1, D42.2, F5.2, U18.1, U18.3, U20.5
V_USB5: C81.1, C90.1, C91.1, D52.1, D52.2, F6.2, U22.1, U22.3, U24.5
V_USB6: C97.1, C106.1, C107.1, D62.1, D62.2, F7.2, U26.1, U26.3, U28.5
V_USB7: C113.1, C122.1, C123.1, D72.1, D72.2, F8.2, U30.1, U30.3, U32.5
V_USB8: C129.1, C138.1, C139.1, D82.1, D82.2, F9.2, U34.1, U34.3, U36.5
V_USB9: C145.1, C154.1, C155.1, D92.1, D92.2, F10.2, U38.1, U38.3, U40.5
V_USB10: C161.1, C170.1, C171.1, D102.1, D102.2, F11.2, U42.1, U42.3, U44.5
V_USB11: C177.1, C186.1, C187.1, D112.1, D112.2, F12.2, U46.1, U46.3, U48.5
