sparkfun/Spectacle_Director_Board/(commit log)

2016-06-13 Incorporate changes from Jim's protos.
    [esp32-thing.brd, esp32-thing.sch]
2016-08-30 Initial commit of finished layout
    [Spectacle_Director_Board.brd, Spectacle_Director_Board.sch]
2016-09-08 For QC review
    [Spectacle_Director_Board.brd, Spectacle_Director_Board.sch]
2016-09-09 Feedback from QC review
    [Spectacle_Director_Board.brd, Spectacle_Director_Board.sch]
2016-09-28 Changes due to Espressif changing chip before release
    [Spectacle_Director_Board.brd, Spectacle_Director_Board.sch]
2016-10-03 Changes from design review for v02
    [Spectacle_Director_Board.brd, Spectacle_Director_Board.sch]
2016-10-04 Feedback from QC review incorporated
    [Spectacle_Director_Board.brd]
2016-11-28 First commit of test Arduino firmware
2016-12-05 v03 - Removing RTC, I2C connector A, adding button, LED.
    [Spectacle_Director_Board.brd, Spectacle_Director_Board.sch]
2016-12-08 initial commit of SAMD21-based director board.
    [Spectacle_Director_Board.brd, Spectacle_Director_Board.sch]
2016-12-09 Cleaning up schematic
    [Spectacle_Director_Board.brd, Spectacle_Director_Board.sch]
2016-12-09 Optimizing routing
    [Spectacle_Director_Board.brd, Spectacle_Director_Board.sch]
2016-12-09 Adjusting some silkscreen.
    [Spectacle_Director_Board.brd]
2016-12-14 Adding second trrs for program, usb out control
    [Spectacle_Director_Board.brd, Spectacle_Director_Board.sch]
2016-12-20 Adding PROD_ID to AP2151.
    [Spectacle_Director_Board.brd, Spectacle_Director_Board.sch]
2016-12-20 Added FSK demodulation hardware Changed pin assignment of FSK channel to channel with comparator Moved power switch FAULT line to a different pin
    [Spectacle_Director_Board.brd, Spectacle_Director_Board.sch]
2016-12-27 FSK demodulation harware layout
    [Spectacle_Director_Board.brd, Spectacle_Director_Board.sch]
2016-12-27 Minor adjustments post-engineer checklist.
    [Spectacle_Director_Board.brd, Spectacle_Director_Board.sch]
2017-01-11 Added Board class, create linked list during config file scan
2017-01-11 New board object contain channel info
2017-01-11 Generic channel handling implemented; memory leak in channel list creation
    [programming.ino]
2017-01-12 Board queueing works; porting to director protos
2017-01-12 Adding UART test points, 32.768kHz RTC crystal
    - Moved flash down about 0.1" to accomodate uart test points
    - Moved SWD test points to accomodate RTC crystal
    [Spectacle_Director_Board.brd, Spectacle_Director_Board.sch]
2017-01-12 Spacing test points by 2mm, increasing via drill size.
    [Spectacle_Director_Board.brd, Spectacle_Director_Board.sch]
2017-01-12 post-checklist fixes - minor re-routing.
    [Spectacle_Director_Board.brd]
2017-01-16 Adding header file guards, renamed dbt.h to i2c_registers.h
2017-01-20 Added non-boolean virtual boards
2017-01-23 Add timer for blink LED, headers to most files
2017-02-03 Incrementing hardware to v10. No other changes.
    [Spectacle_Director_Board.brd, Spectacle_Director_Board.sch]
2017-02-03 Updating silkscreen on PROG button and stat LED's
    [Spectacle_Director_Board.brd]
2017-02-03 Adding bottom-side arrow indicator to Direct port
    [Spectacle_Director_Board.brd]
2017-02-08 Mostly cleanup - Removed some commented code - Commented some debugging prints - Added some header info - Move some defines to header files - Adjusted code to remove second comparator functions - Adj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
